igkov/lasdev/hw/readme.txt

Схема встраиваемого модуля и печатная плата.
