igkov/lasdev/pc-simple-hid/readme.txt

Пример общения с устройством под Win32. Получение данных HID.

Максимально упрощенный пример в одном исходнике, предоставляющий возможность встроить в приложение взаимодействие с дальномером по USB.

Распространяется в исходниках.
