igkov/lasdev/hw-pics/lasdev_v1b.png

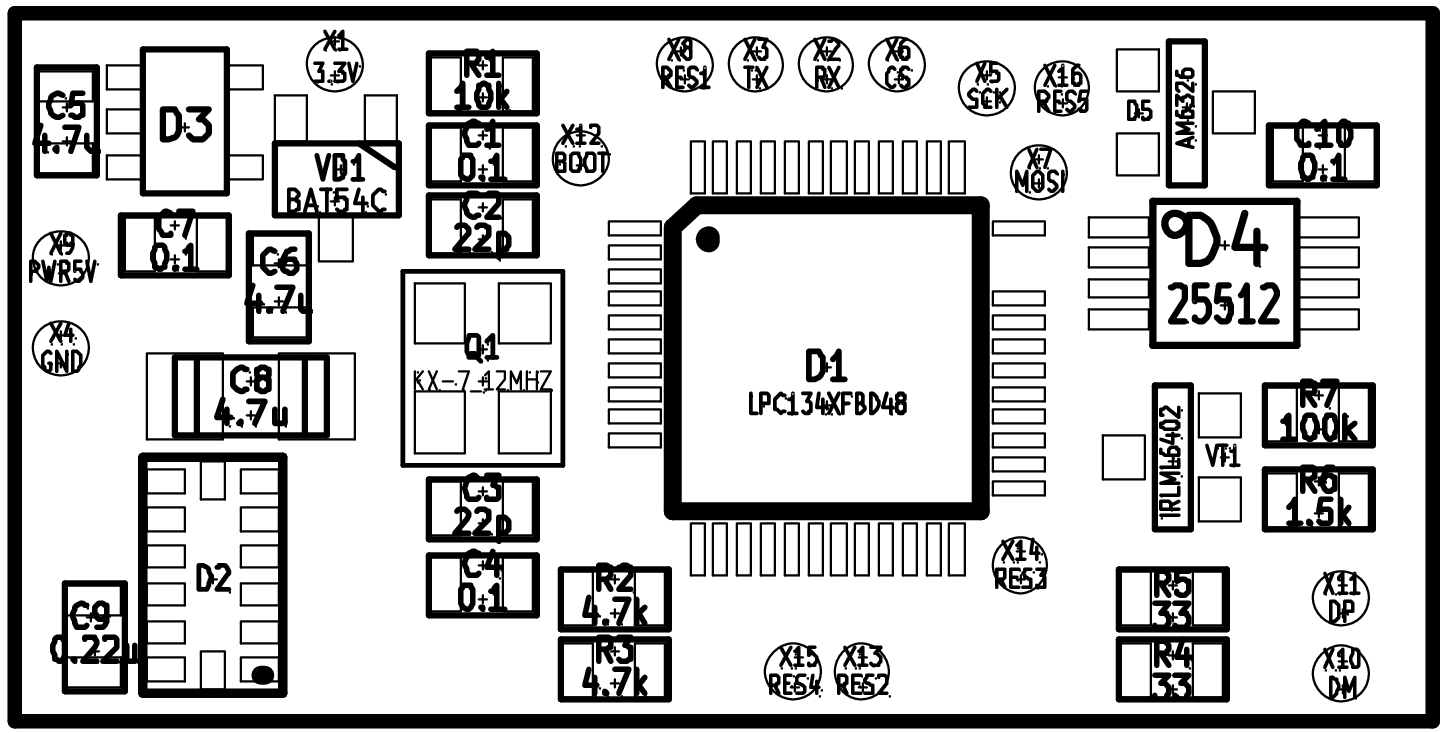
hw-pics/lasdev_v1b.png
