igkov/lasdev/hw-pics/lasdev_v1b_pic2.png

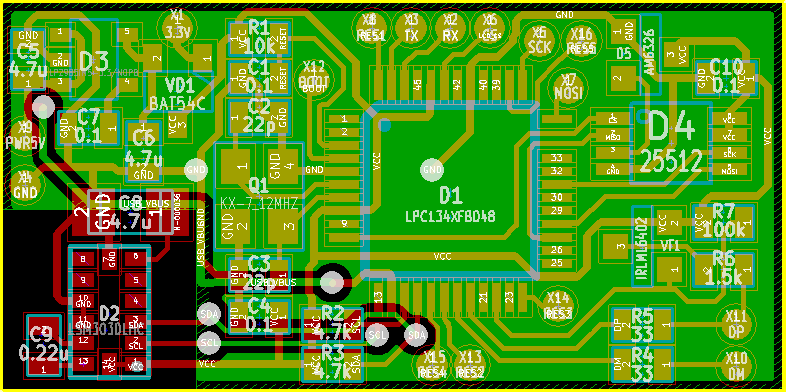
hw-pics/lasdev_v1b_pic2.png
