igkov/lasdev/hw-pics/lasdev_v1b_pic.png

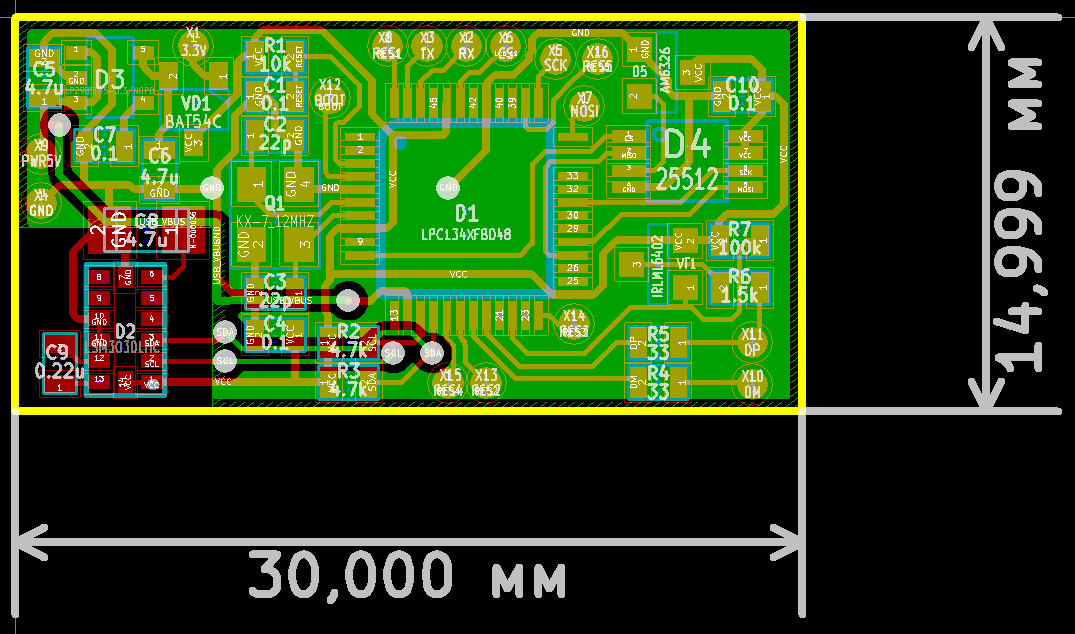
hw-pics/lasdev_v1b_pic.png
