igkov/lasdev/hw-pics/lasdev_v1.pdf

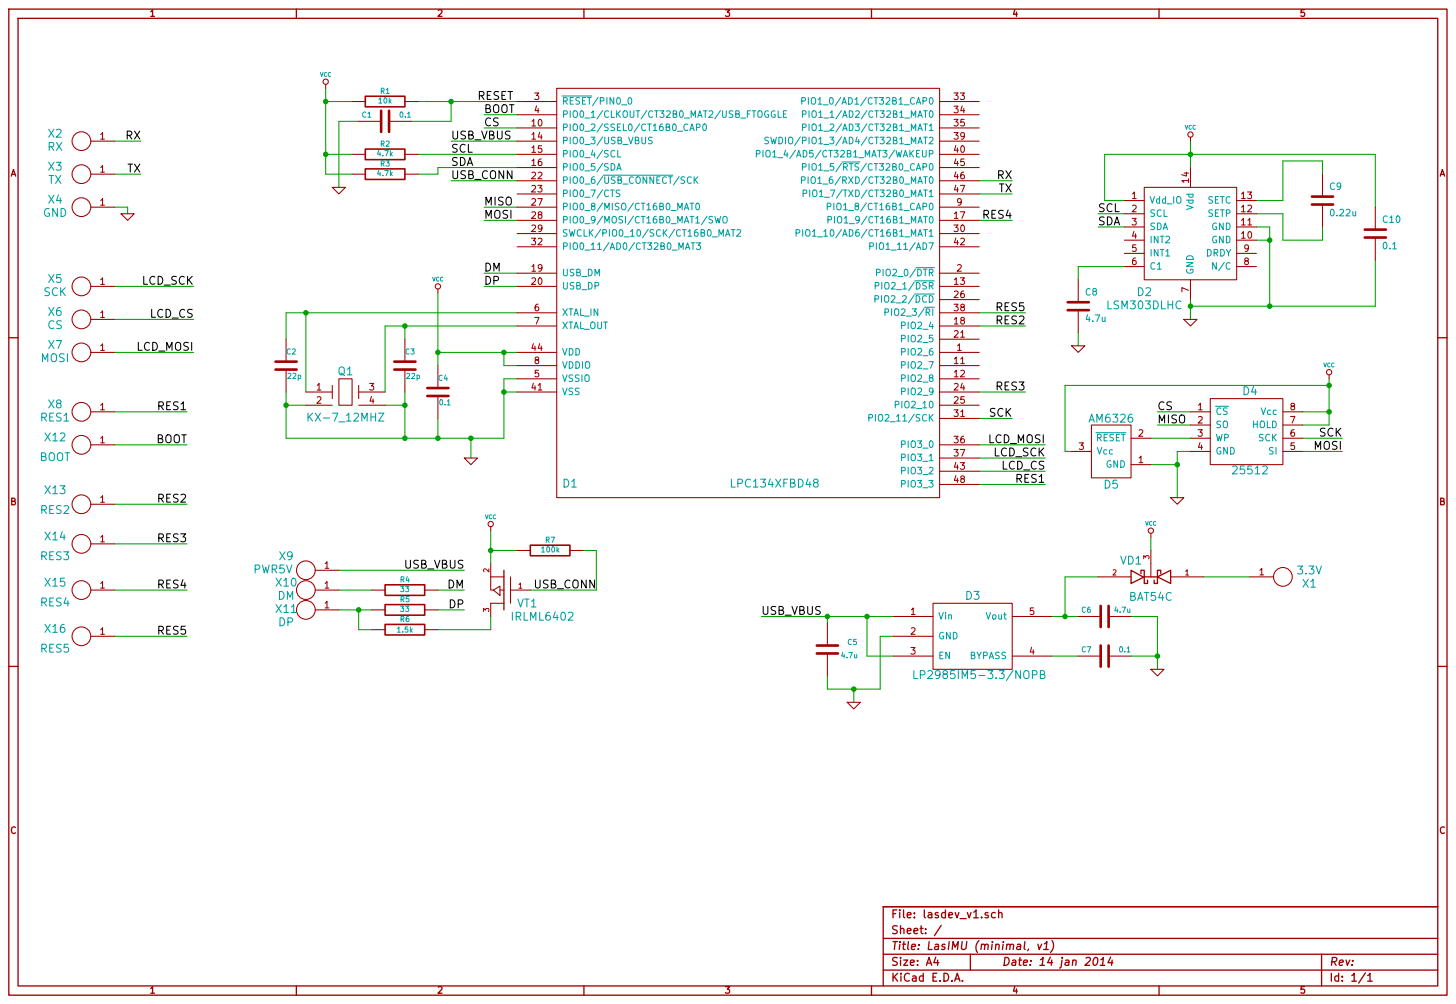
[picture p8: page 1]

7 N/C 8 DRDY 9 GND 10 GND 11 SETP 12 SETC 13 Vdd 14 D2
