igkov/lasdev/hw/lasdev_v1.sch

## KiCad design hw/lasdev_v1.sch (2018-10-25)

Schematic: lasdev_v1.sch

Parts:
C1, C4, C7: 0.1
C2, C3: 22p
C5, C6: 4.7u
C8: 4.7u
C9: 0.22u
C10: 0.1
D1: LPC134XFBD48
D2: LSM303DLHC
D3: LP2985IM5-3.3/NOPB
D4: 25512
D5: AM6326
Q1: KX-7_12MHZ
R1: 10k
R2, R3: 4.7k
R4, R5: 33
R6: 1.5k
R7: 100k
VD1: BAT54C
VT1: IRLML6402
X1: 3.3V
X2: RX
X3: TX
X4: GND
X5: SCK
X6: CS
X7: MOSI
X8: RES1
X9: PWR5V
X10: DM
X11: DP
X12: BOOT
X13: RES2
X14: RES3
X15: RES4
X16: RES5
