igkov/lasdev/pc/loader.c

#include <stdint.h>
uint32_t loader_len = 3544;
uint8_t loader_bin[] = {
	0xd0, 0x07, 0x00, 0x10, 0x01, 0x03, 0x00, 0x00, 0x11, 0x03, 0x00, 0x00, 0x25, 0x03, 0x00, 0x00, 0x39, 0x03, 0x00, 0x00, 0x4d, 0x03, 0x00, 0x00, 0x61, 0x03, 0x00, 0x00, 0x12, 0xe5, 0xff, 0xef, 
	0x00, 0x00, 0x00, 0x00, 0x00, 0x00, 0x00, 0x00, 0x00, 0x00, 0x00, 0x00, 0x75, 0x03, 0x00, 0x00, 0x89, 0x03, 0x00, 0x00, 0x78, 0x56, 0x34, 0x12, 0x9d, 0x03, 0x00, 0x00, 0xb1, 0x03, 0x00, 0x00, 
	0xc5, 0x03, 0x00, 0x00, 0xc5, 0x03, 0x00, 0x00, 0xc5, 0x03, 0x00, 0x00, 0xc5, 0x03, 0x00, 0x00, 0xc5, 0x03, 0x00, 0x00, 0xc5, 0x03, 0x00, 0x00, 0xc5, 0x03, 0x00, 0x00, 0xc5, 0x03, 0x00, 0x00, 
	0xc5, 0x03, 0x00, 0x00, 0xc5, 0x03, 0x00, 0x00, 0xc5, 0x03, 0x00, 0x00, 0xc5, 0x03, 0x00, 0x00, 0xc5, 0x03, 0x00, 0x00, 0xc5, 0x03, 0x00, 0x00, 0xc5, 0x03, 0x00, 0x00, 0xc5, 0x03, 0x00, 0x00, 
	0xc5, 0x03, 0x00, 0x00, 0xc5, 0x03, 0x00, 0x00, 0xc5, 0x03, 0x00, 0x00, 0xc5, 0x03, 0x00, 0x00, 0xc5, 0x03, 0x00, 0x00, 0xc5, 0x03, 0x00, 0x00, 0xc5, 0x03, 0x00, 0x00, 0xc5, 0x03, 0x00, 0x00, 
	0xc5, 0x03, 0x00, 0x00, 0xc5, 0x03, 0x00, 0x00, 0xc5, 0x03, 0x00, 0x00, 0xc5, 0x03, 0x00, 0x00, 0xc5, 0x03, 0x00, 0x00, 0xc5, 0x03, 0x00, 0x00, 0xc5, 0x03, 0x00, 0x00, 0xc5, 0x03, 0x00, 0x00, 
	0xc5, 0x03, 0x00, 0x00, 0xc5, 0x03, 0x00, 0x00, 0xc5, 0x03, 0x00, 0x00, 0xc5, 0x03, 0x00, 0x00, 0xc5, 0x03, 0x00, 0x00, 0xc5, 0x03, 0x00, 0x00, 0xc5, 0x03, 0x00, 0x00, 0xc5, 0x03, 0x00, 0x00, 
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
	0xff, 0xf7, 0x10, 0xbf, 0xfe, 0xe7, 0x4f, 0xf0, 0x80, 0x50, 0x40, 0x68, 0x20, 0xb1, 0x4f, 0xf4, 0x84, 0x50, 0x00, 0x68, 0xff, 0xf7, 0x06, 0xbf, 0xfe, 0xe7, 0x4f, 0xf0, 0x80, 0x50, 0x40, 0x68, 
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
};
