igkov/lasdev/mcu-frw/spi.h

#ifndef __HAL_SPI_H__
#define __HAL_SPI_H__

void spi_init(void);
unsigned char spi_send(unsigned char bSend);
void spi_select(void);
void spi_unselect(void);

//#if defined( _LPC1300_ )

/* SSP Status register */
#define SSPSR_TFE		(1 << 0)
#define SSPSR_TNF		(1 << 1) 
#define SSPSR_RNE		(1 << 2)
#define SSPSR_RFF		(1 << 3) 
#define SSPSR_BSY		(1 << 4)

/* SSP CR0 register */
#define SSPCR0_DSS		(1 << 0)
#define SSPCR0_FRF		(1 << 4)
#define SSPCR0_SPO		(1 << 6)
#define SSPCR0_SPH		(1 << 7)
#define SSPCR0_SCR		(1 << 8)

/* SSP CR1 register */
#define SSPCR1_LBM		(1 << 0)
#define SSPCR1_SSE		(1 << 1)
#define SSPCR1_MS		(1 << 2)
#define SSPCR1_SOD		(1 << 3)

//#endif

#endif // __HAL_SPI_H__ 
