igkov/lasdev/mcu-frw/type.h

/*****************************************************************************
 *   type.h:  Type definition Header file for NXP Family 
 *   Microprocessors
 *
 *   Copyright(C) 2006, NXP Semiconductor
 *   All rights reserved.
 *
 *   History
 *   2009.04.01  ver 1.00    Preliminary version, first Release
 *
******************************************************************************/
#ifndef __TYPE_H__
#define __TYPE_H__

#include <stdint.h>

#ifndef NULL
#define NULL    ((void *)0)
#endif

#ifndef FALSE
#define FALSE   (0)
#endif

#ifndef TRUE
#define TRUE    (1)
#endif

#endif  /* __TYPE_H__ */
