igkov/lasdev/pc/resource.h

#ifndef __RESOURCE_H__
#define __RESOURCE_H__

#define IDS_HELLO         1
#define IDS_GOODBYE       2
#define IDS_AUTHOR        3
#define IDS_INFO          4
#define IDS_COPYRIGHT     5
#define IDS_CONTACTS1     6
#define IDS_CONTACTS2     7
#define IDS_CONTACTS3     8
#define IDS_CONTACTS4     9
#define IDS_CONTACTS5     10

#define IDD_DLG1  1000

#define IDC_BTN_EXIT         1001
#define IDC_BTN_SAVE_CONFIG  1002
#define IDC_BTN_LOAD_CONFIG  1003
#define IDC_BTN_LOAD_FILE    1004
#define IDC_BTN_SAVE_FILE    1005
#define IDC_BTN_CALIBRATE    1006

#define IDC_STC1             1101
#define IDC_STC2             1102
#define IDC_STC3             1103
#define IDC_STC4             1104
#define IDC_STC5             1105
#define IDC_STC6             1106
#define IDC_STC7             1107
#define IDC_STC8             1108
#define IDC_STC9             1109
#define IDC_STC10            1110
#define IDC_STC11            1111
#define IDC_STC12            1112
#define IDC_STC13            1113
#define IDC_STC14            1114
#define IDC_STC15            1115
#define IDC_STC16            1116
#define IDC_STC17            1117
#define IDC_STC18            1118

#define IDC_EDT_CNFVER       1201
#define IDC_EDT_HWVER        1202
#define IDC_EDT_SN           1203
#define IDC_EDT_MEMSIZE      1204
#define IDC_EDT_ACC_KX       1205
#define IDC_EDT_ACC_KY       1206
#define IDC_EDT_ACC_KZ       1207
#define IDC_EDT_ACC_OX       1208
#define IDC_EDT_ACC_OY       1209
#define IDC_EDT_ACC_OZ       1210
#define IDC_EDT_MAG_KX       1211
#define IDC_EDT_MAG_KY       1212
#define IDC_EDT_MAG_KZ       1213
#define IDC_EDT_MAG_OX       1214
#define IDC_EDT_MAG_OY       1215
#define IDC_EDT_MAG_OZ       1216
#define IDC_EDT_ACC_MESHX    1217
#define IDC_EDT_ACC_MESHY    1218
#define IDC_EDT_ACC_MESHZ    1219
#define IDC_EDT_MAG_MESHX    1220
#define IDC_EDT_MAG_MESHY    1221
#define IDC_EDT_MAG_MESHZ    1222
#define IDC_EDT_MAG_DECL     1223
#define IDC_EDT_TILT_COMP    1224


#endif // __RESOURCE_H__
