igkov/lasdev/(commit log)

2018-10-25 Add all project files.
    [lasdev_v1.brd, lasdev_v1.sch]
2018-11-12 Update event.c to actual version 2.0 (without slots).
2018-11-17 Fix PC-util (now it build).
    [loader.c, main.c]
